kaiicheng/CPR-For-All/CPR for All Final Presentation.pdf

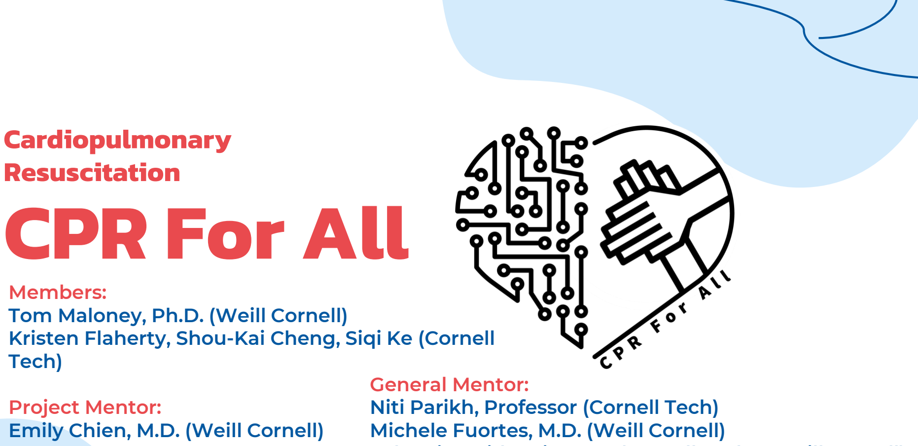
[picture p6: figure]
Cardiopulmonary Resuscitation CPR For All; Members: Tom Maloney, Ph.D. (Weill Cornell); Tech); Project Mentor: Emily Chien, M.D. (Weill Cornell); General Mentor: Niti Parikh, Professor (Cornell Tech) Michele Fuortes, M.D. (Weill Cornell)

Kristen Flaherty, Shou-Kai Cheng, Siqi Ke (Cornell

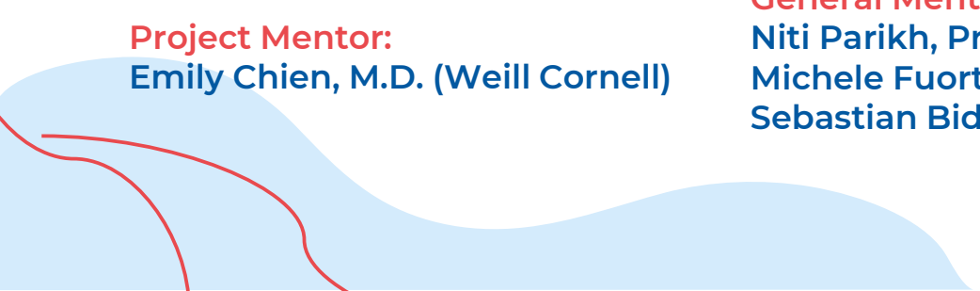
[picture p7: figure]

Sebastian Bidegain, M.D. (Cornell Tech & Weill Cornell)

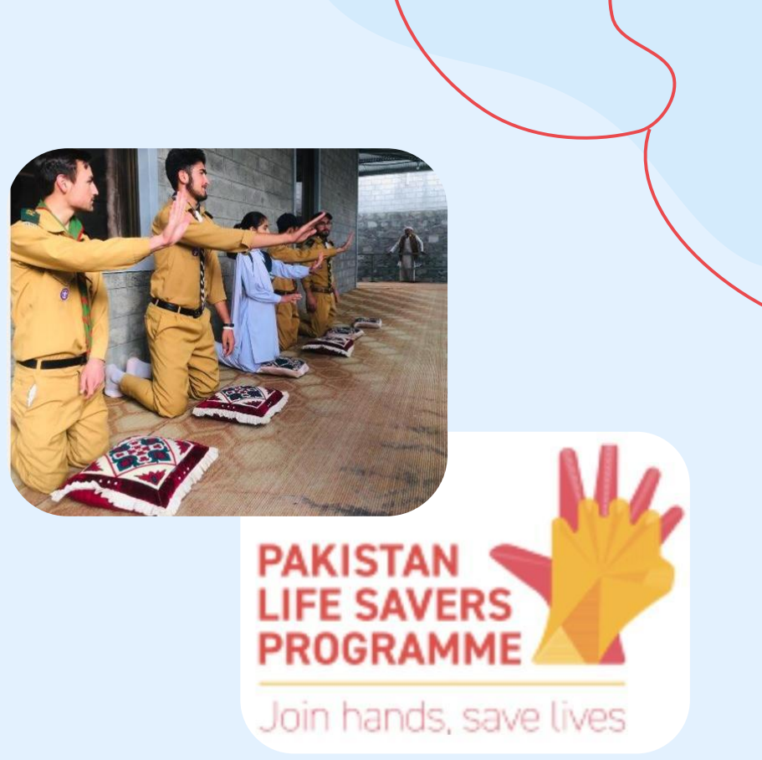
[picture p8: figure]

# The Challenge

### CRP For All

## How Might We create a low-cost version of a CPR model that appropriately simulates the compression force and depth required for high-quality CPR?

# User Groups & Needs

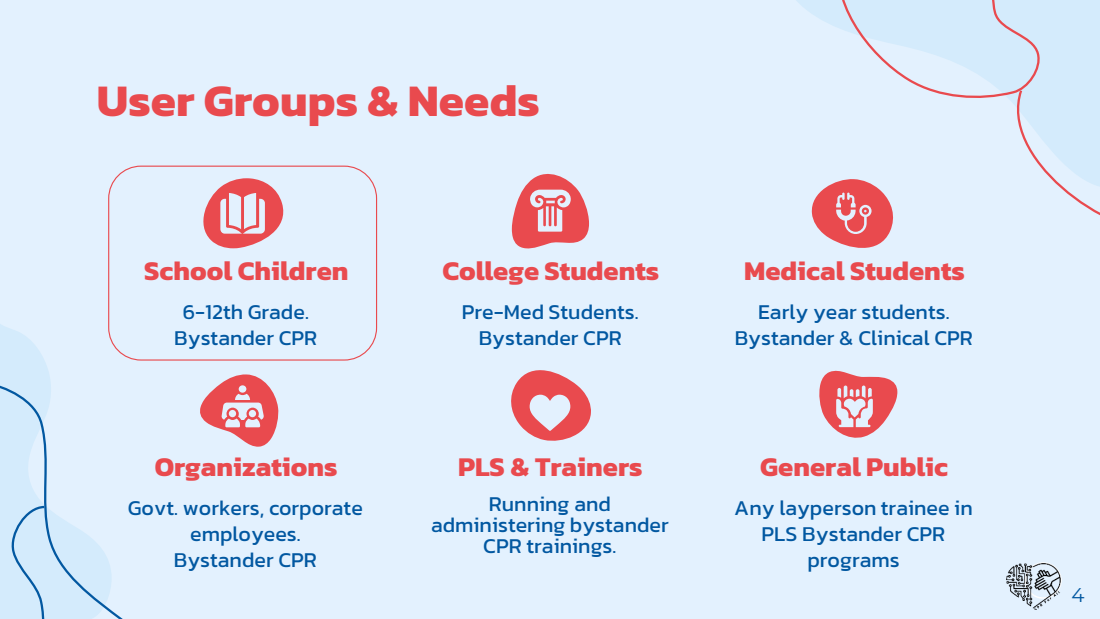
[picture p9: page 3]
PLS & Trainers Running and administering bystander CPR trainings.; School Children 6-12th Grade. Bystander CPR

College Students
Pre-Med Students.
Bystander CPR

Medical Students
Early year students.
Bystander & Clinical CPR

Organizations
Govt. workers, corporate
employees.

General Public
Any layperson trainee in
PLS Bystander CPR
programs

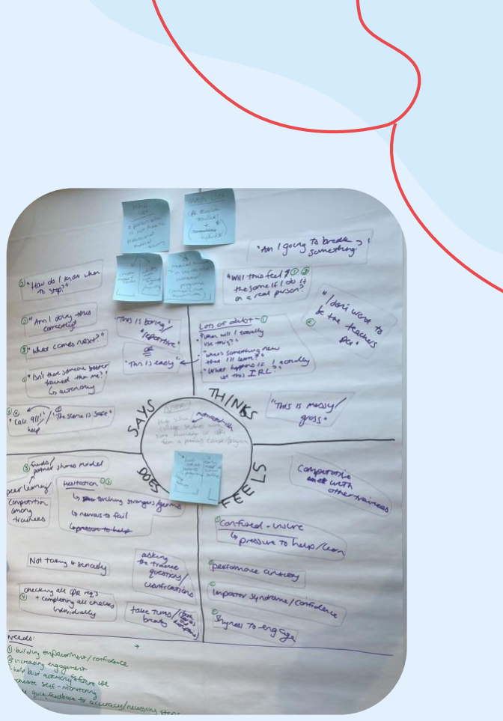
[picture p10: figure]

# Design Challenge Framework

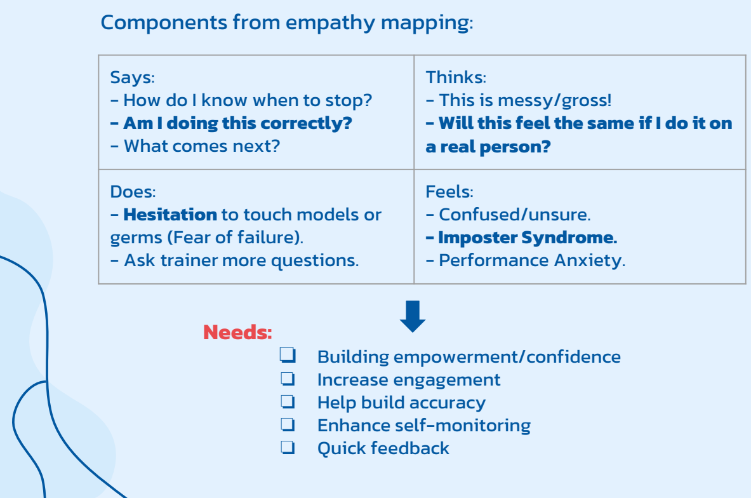
[picture p11: figure]
Needs:; ❏ Building empowerment/confidence ❏ Increase engagement ❏ Help build accuracy ❏ Enhance self-monitoring ❏ Quick feedback; Components from empathy mapping:

Says: - How do I know when to stop? - Am I doing this correctly? - What comes next? | Thinks: - This is messy/gross! - Will this feel the same if I do it on a real person?
Does: - Hesitation to touch models or germs (Fear of failure). - Ask trainer more questions. | Feels: - Confused/unsure. - Imposter Syndrome. - Performance Anxiety.

# Interview Takeaways

Pakistan Life Savers Program

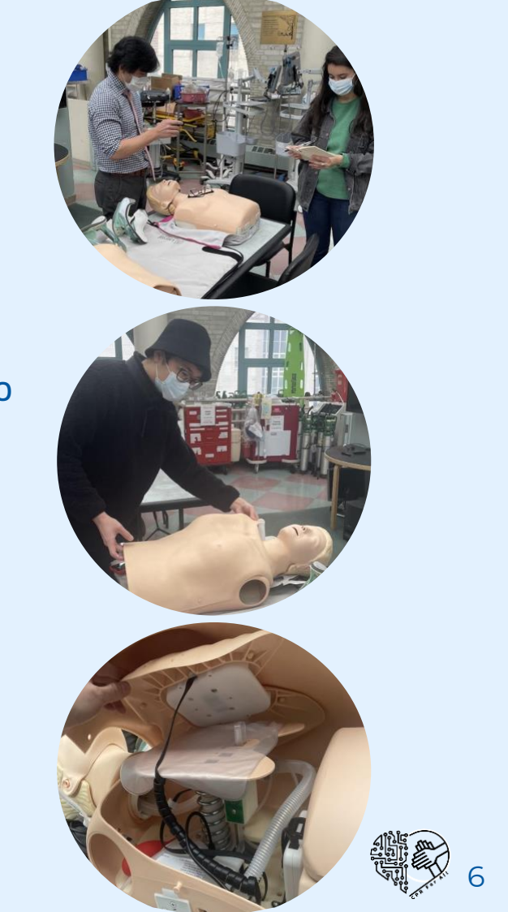
[picture p12: figure]

- Recent implementation of CPR into national education curriculum, ~10 million students 6th-12th grade
- Every trainee has one pillow and shares an expensive training mannequin
- Low resourced, high work output
- Need an affordable, portable, scalable, reproducible CPR model to deploy in their programs
CPR Training
- Compressions (depth, rate, hand placement, length) is necessary to teach in bystander CPR over ventilation
- 2-2.5 inches deep at 100-120 cpm for 2 minutes
- Deliver high quality, intuitive feedback without increasing cost

### 4 Emergency Medicine Physicians @ Weill Cornell

# Project Goals & Constraints

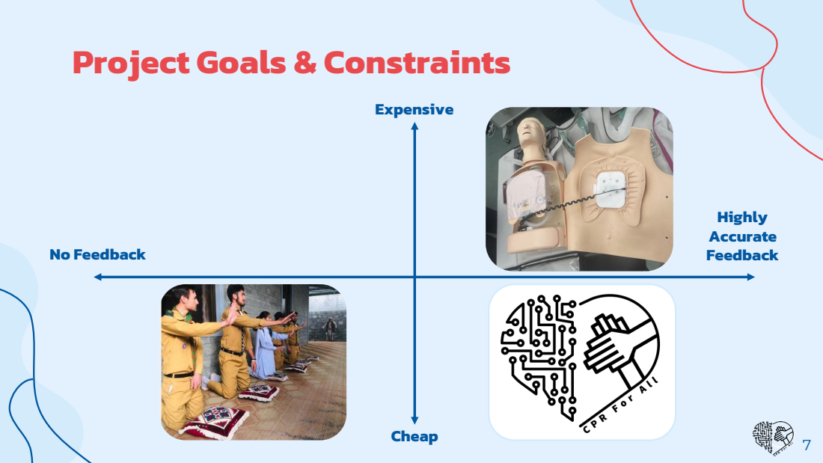
[picture p13: page 6]
Expensive; Cheap; No Feedback; Highly Accurate Feedback

# Project Goals & Constraints

## Goals ❏ Compression only ❏ Accurate depth and rate feedback ❏ Scalable and portable for schools

## Constraints

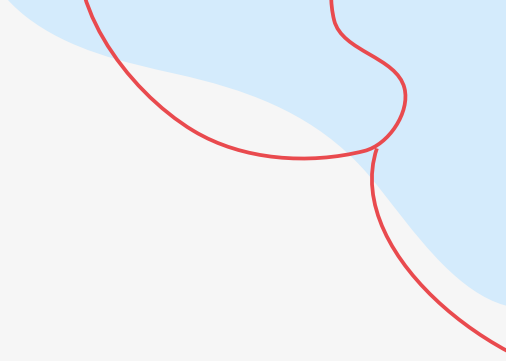
[picture p14: figure]

## ❏ Low cost, affordable objects ❏ Reproducible ❏ Easy to assemble ❏ Repairable

# Prototype

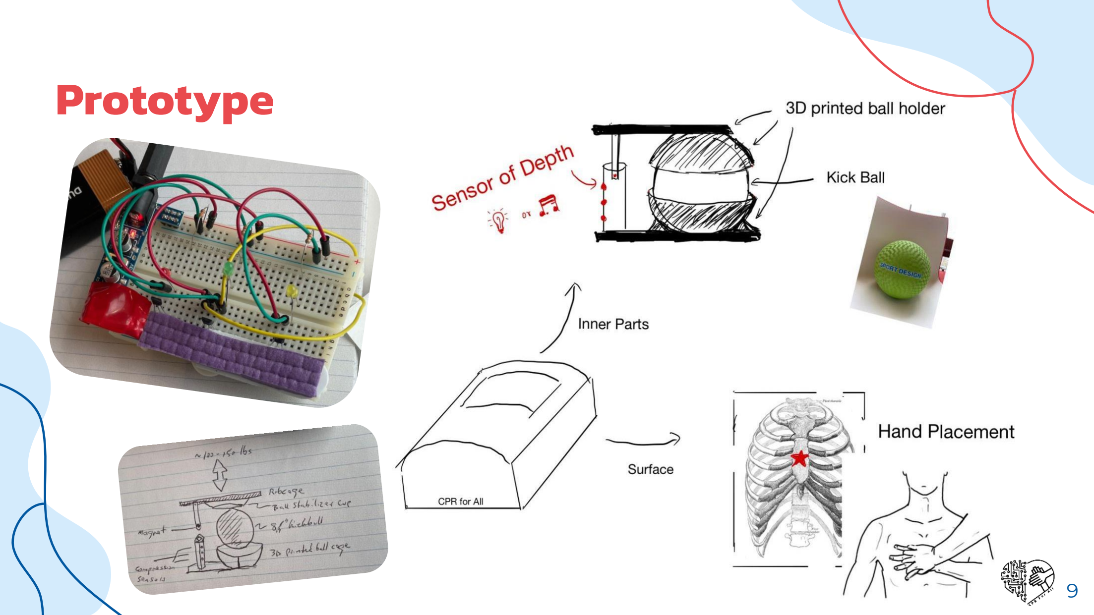
[picture p15: page 8]

# Final CPR Compression Trainer

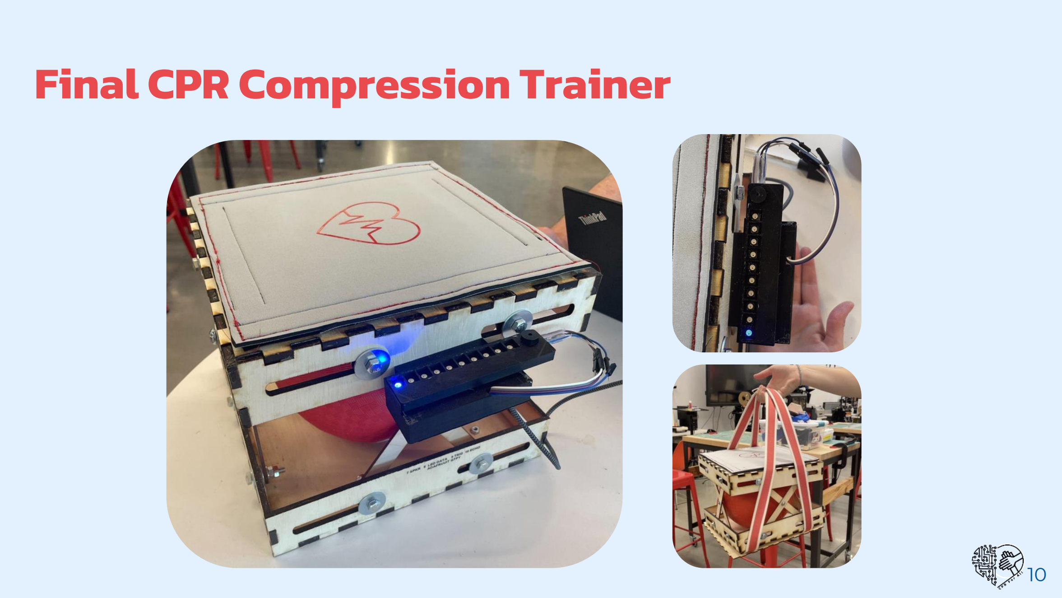
[picture p16: page 9]
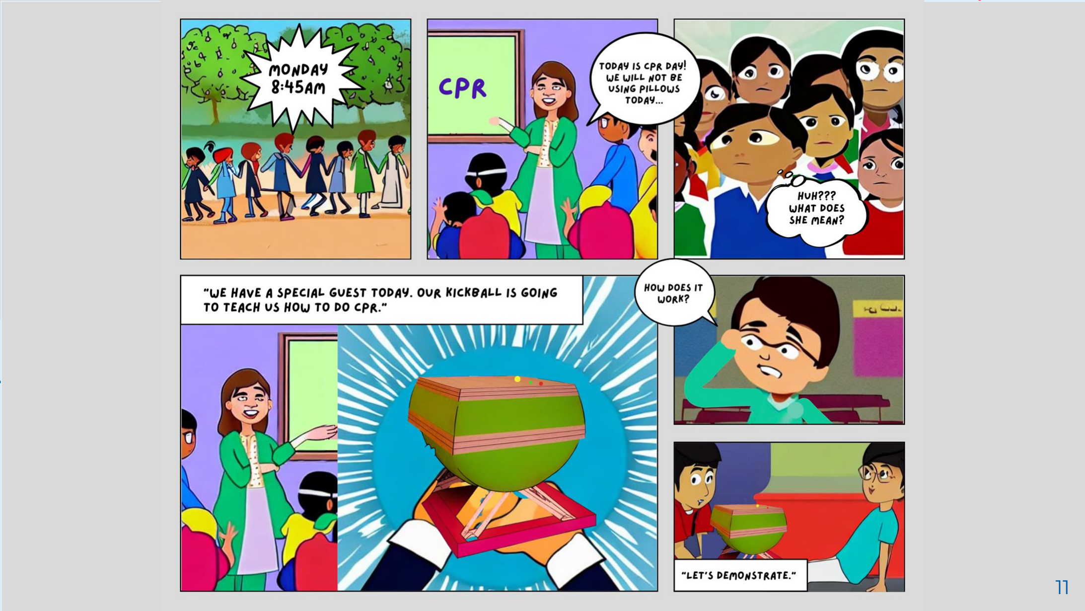
[picture p17: page 10]
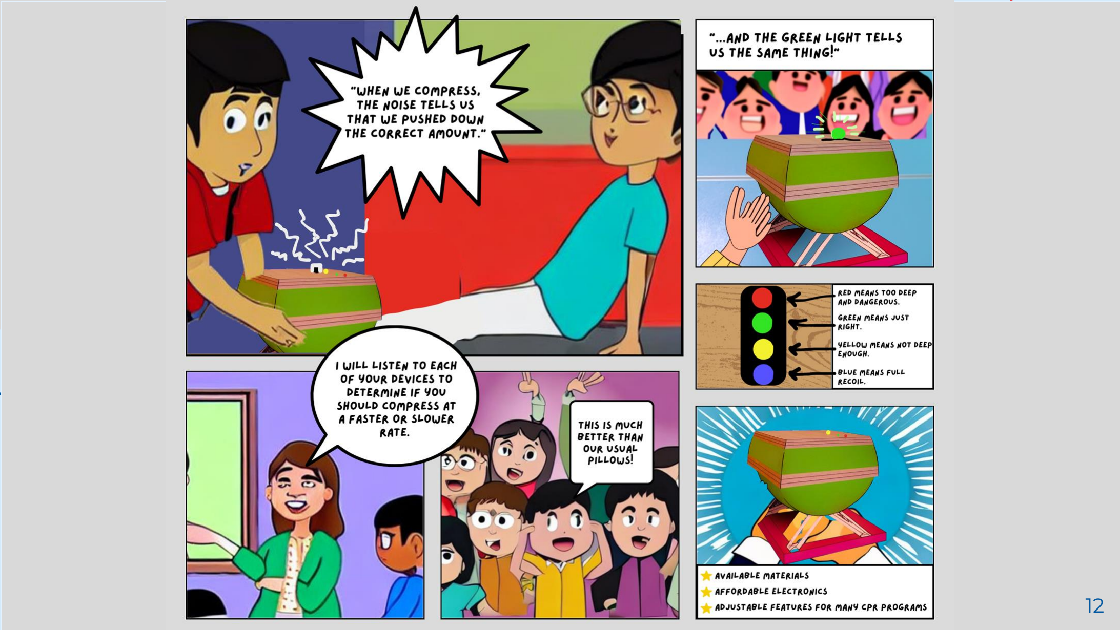
[picture p18: page 11]

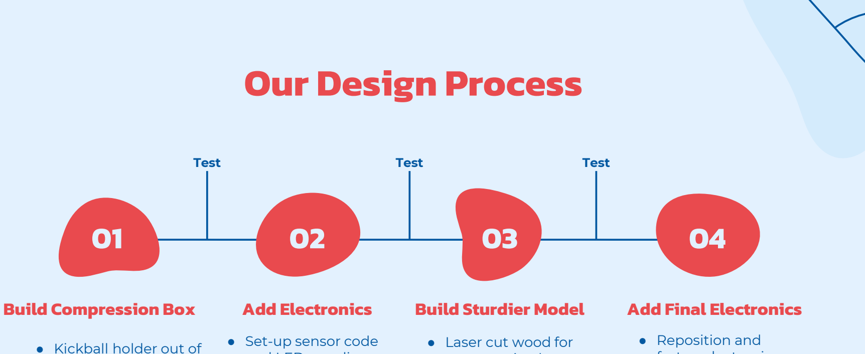
[picture p19: figure]
Our Design Process; Build Compression Box; Add Electronics; Build Sturdier Model; Add Final Electronics; ● Set-up sensor code; ● Laser cut wood for; ● Reposition and; Test

- Kickball holder out of
cardboard

and LED + audio
feedback on
compression depth

compression box
- 3D-printed pieces
to hold electronics

fasten electronics
and all parts

# Cardboard Model

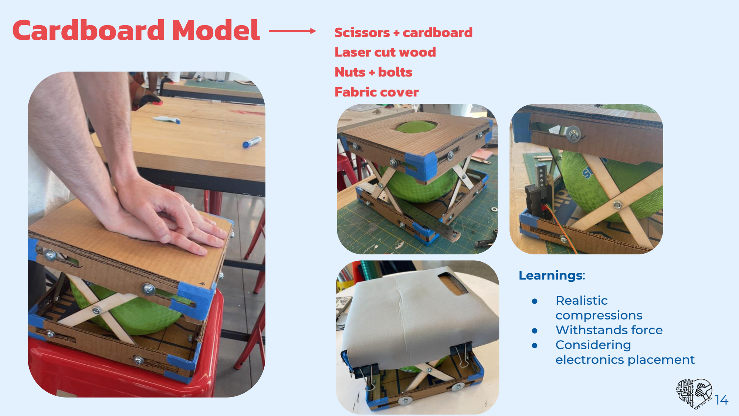
[picture p20: page 13]

Learnings:
- Realistic
compressions
- Withstands force
- Considering
electronics placement

Scissors + cardboard
Laser cut wood
Nuts + bolts
Fabric cover

# Cardboard Model + Electronics

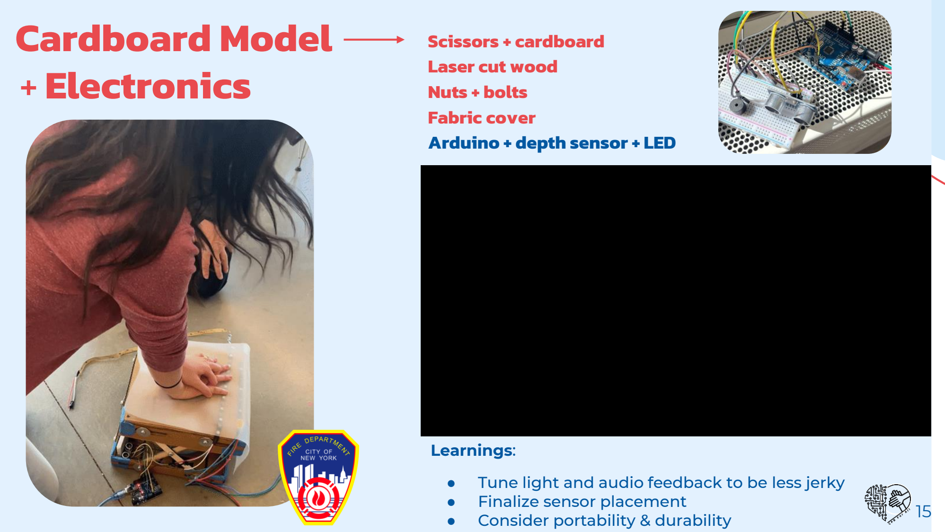
[picture p21: page 14]

Learnings:
- Tune light and audio feedback to be less jerky
- Finalize sensor placement
- Consider portability & durability

Scissors + cardboard
Laser cut wood
Nuts + bolts
Fabric cover
Arduino + depth sensor + LED

# Final CPR Model

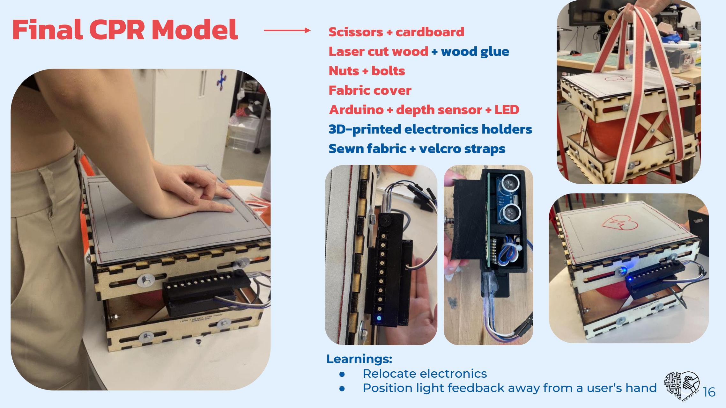
[picture p22: page 15]

Learnings:
- Relocate electronics
- Position light feedback away from a user’s hand

Scissors + cardboard
Laser cut wood + wood glue Nuts + bolts
Fabric cover
Arduino + depth sensor + LED 3D-printed electronics holders Sewn fabric + velcro straps

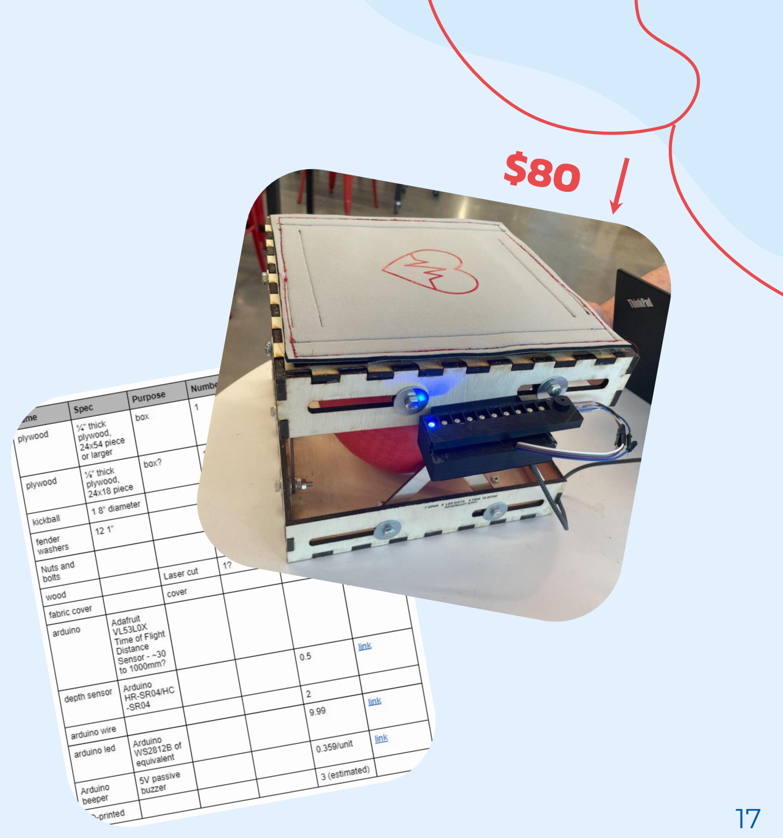
[picture p23: figure]

# User Manual and Costs

- User manual (link (https://docs.google.com/document/d/1pwOQY6LLWeu2-WrqhiwFXcap4NURnqS5RL8z-PJ1cMg/edit)

)
- | Supplies ○ | DIY instructions ○ Building process ○ | Arduino code ○ | Laser cut wood file ○ | Estimated costs (below $80)
- Keep improving our model for ○ | May 19: Spring 2023 Open
| Studio
- July 17: International
| Symposium on Academic Makerspaces 2023

# Thanks!

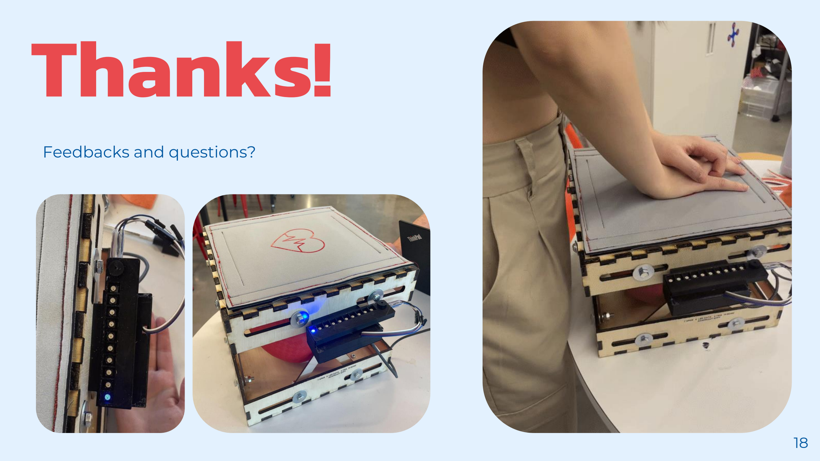
[picture p24: page 17]

CREDITS: This presentation template was created by Slidesgo, (http://bit.ly/2Tynxth) including icons by Flaticon, (http://bit.ly/2TyoMsr) and infographics & images by Freepik (http://bit.ly/2TtBDfr)

Feedbacks and questions?
