kaiicheng/CPR-For-All/CPR for All Mid-Checkpoint Presentation.pdf

## Cardiopulmonary Resuscitation

# CPR For All

Tom Maloney (Weill Cornell)

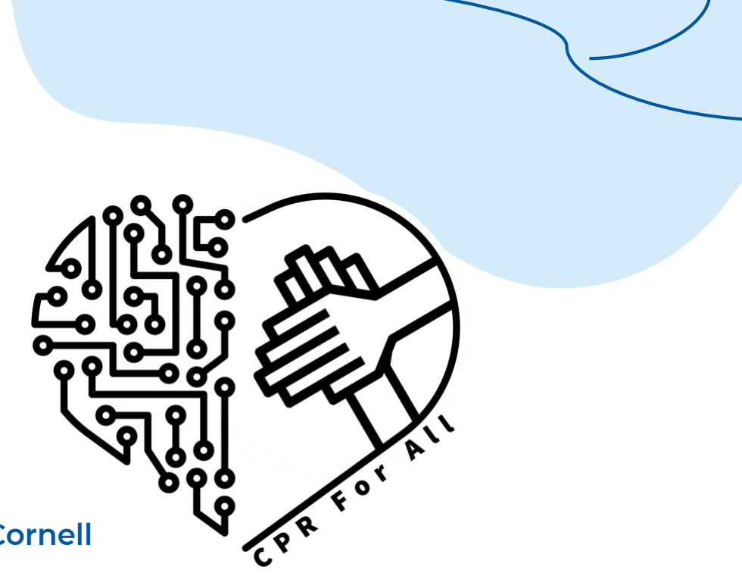
[picture p29: figure]

Kristen Flaherty, Shou-Kai Cheng, Siqi Ke (Cornell

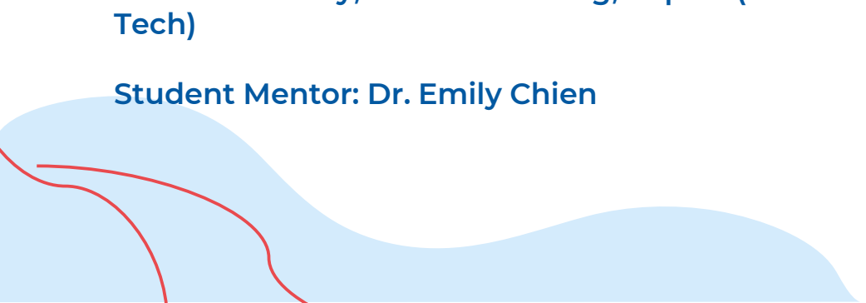
[picture p30: figure]
Tech); Student Mentor: Dr. Emily Chien

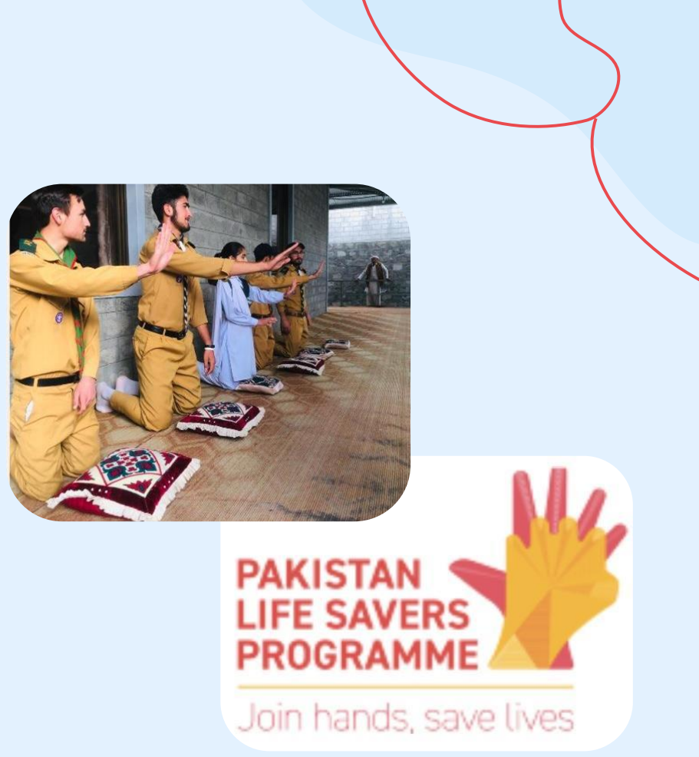
[picture p31: figure]

# The Challenge

### CRP For All

## How Might We create a low-cost version of a CPR model that

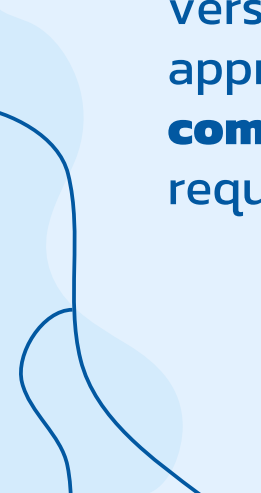
[picture p32: figure]

## appropriately simulates the compression force and depth required for high-quality CPR?

# User Groups & Needs

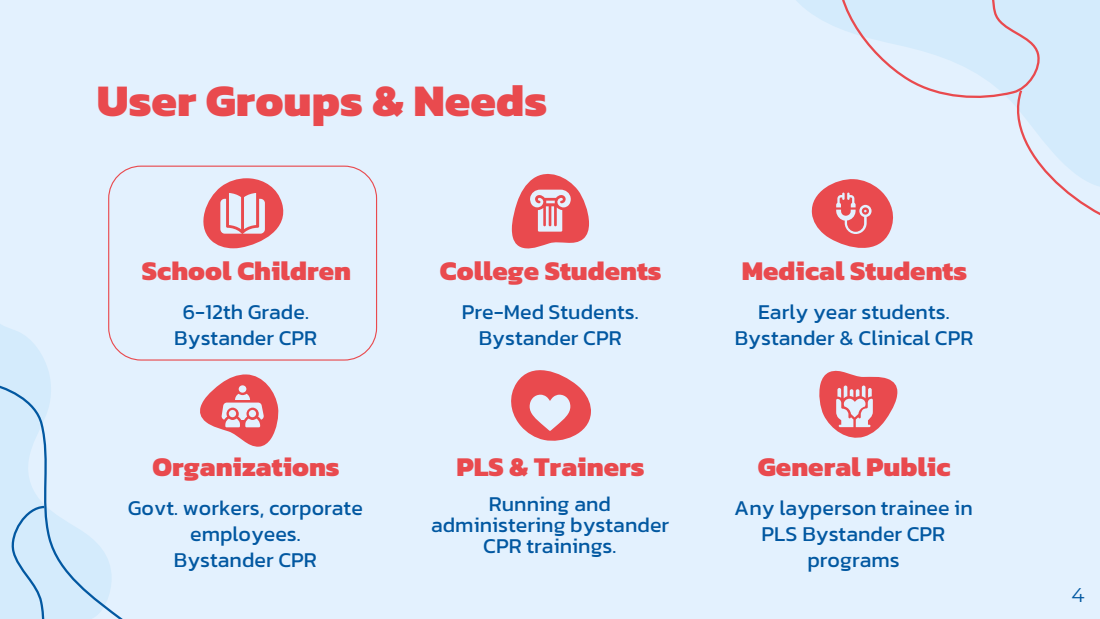
[picture p33: page 3]
PLS & Trainers Running and administering bystander CPR trainings.; School Children 6-12th Grade. Bystander CPR

College Students
Pre-Med Students.
Bystander CPR

Medical Students
Early year students.
Bystander & Clinical CPR

Organizations
Govt. workers, corporate
employees.

General Public
Any layperson trainee in
PLS Bystander CPR
programs

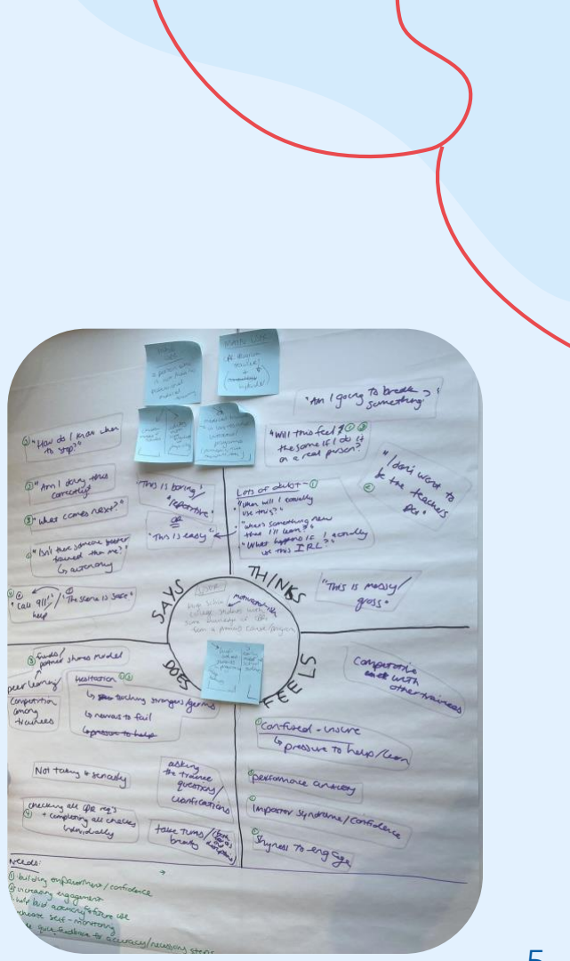
[picture p34: figure]

# Design Challenge Framework

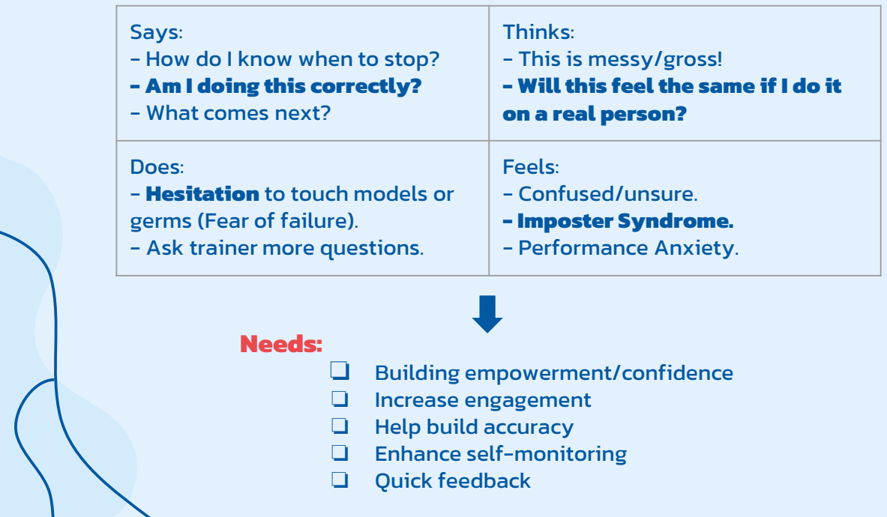
[picture p35: figure]
Needs:; ❏ Building empowerment/confidence ❏ Increase engagement ❏ Help build accuracy ❏ Enhance self-monitoring ❏ Quick feedback

Says: - How do I know when to stop? - Am I doing this correctly? - What comes next? | Thinks: - This is messy/gross! - Will this feel the same if I do it on a real person?
Does: - Hesitation to touch models or germs (Fear of failure). - Ask trainer more questions. | Feels: - Confused/unsure. - Imposter Syndrome. - Performance Anxiety.

Components from empathy mapping:

# Interview Takeaways

Pakistan Life Savers Program

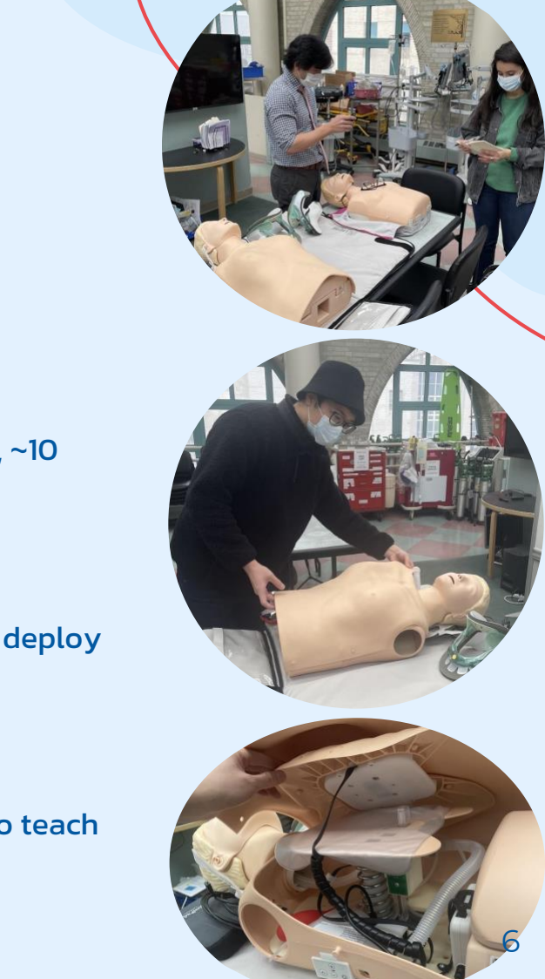
[picture p36: figure]

- Recent implementation of CPR into national education curriculum, ~10

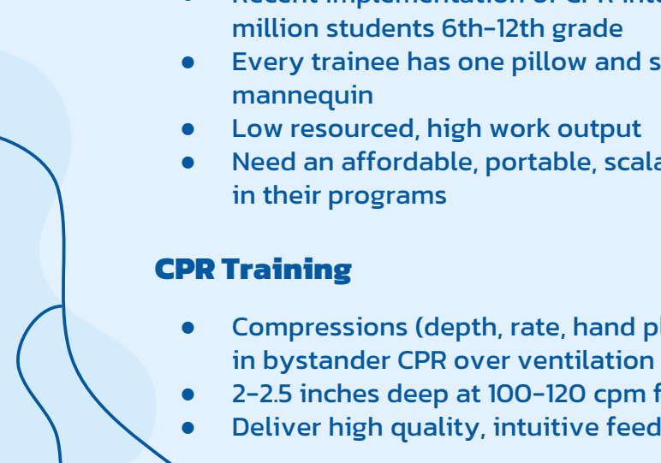
[picture p37: figure]
million students 6th-12th grade; mannequin ● Low resourced, high work output; in their programs CPR Training; in bystander CPR over ventilation

- Every trainee has one pillow and shares an expensive training
- Need an affordable, portable, scalable, reproducible CPR model to deploy
- Compressions (depth, rate, hand placement, length) is necessary to teach
- 2-2.5 inches deep at 100-120 cpm for 2 minutes
- Deliver high quality, intuitive feedback without increasing cost

### 4 Emergency Medicine Physicians @ Weill Cornell

# Project Goals & Constraints

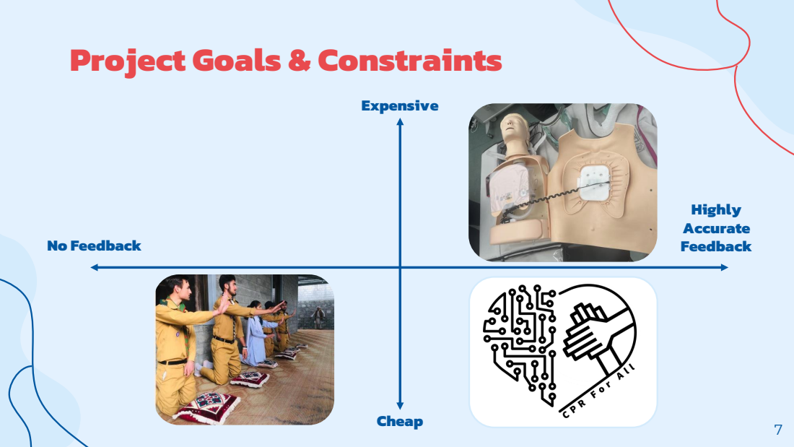
[picture p38: page 6]
Expensive; Cheap; No Feedback; Highly Accurate Feedback

# Project Goals & Constraints

## Goals ❏ Compression only ❏ Accurate depth and rate feedback ❏ Scalable and portable for schools

## Constraints

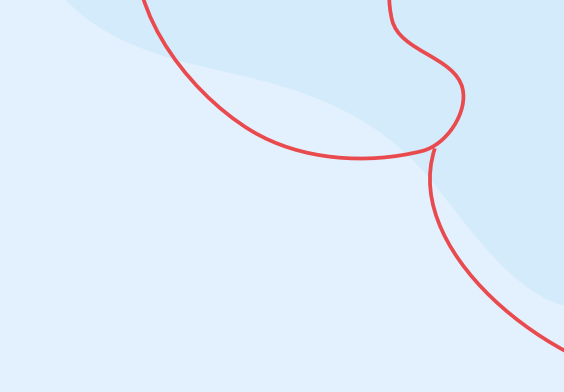
[picture p39: figure]

## ❏ Low cost, affordable objects ❏ Reproducible ❏ Easy to assemble ❏ Repairable

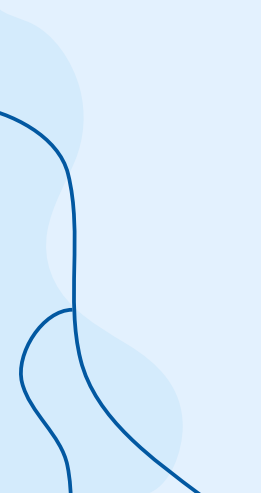
[picture p40: figure]

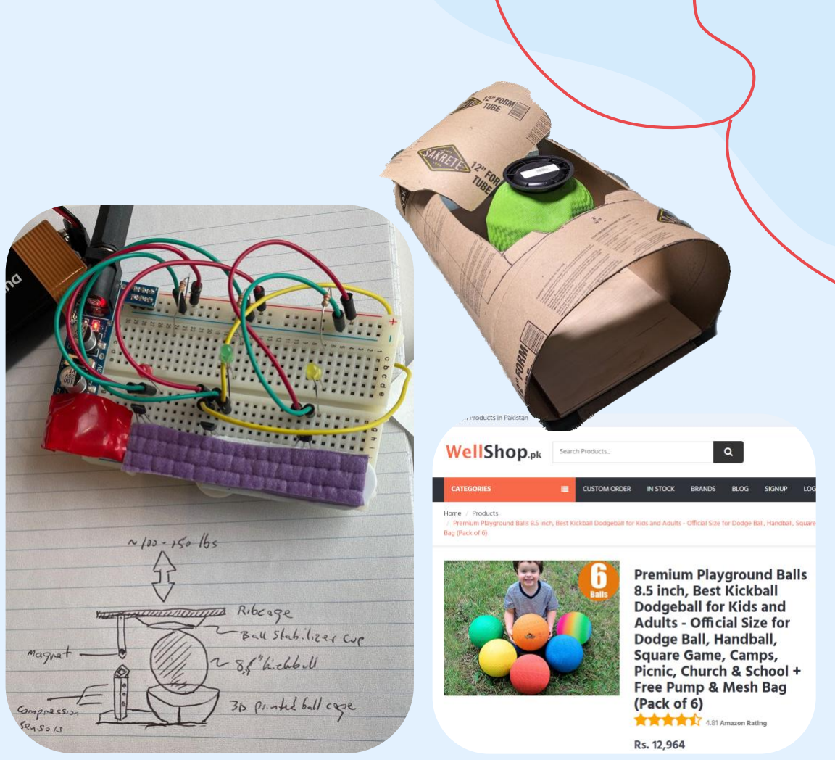
[picture p41: figure]

Proof of Concept ❏ Compression training device ❏ Using a kickball to simulate

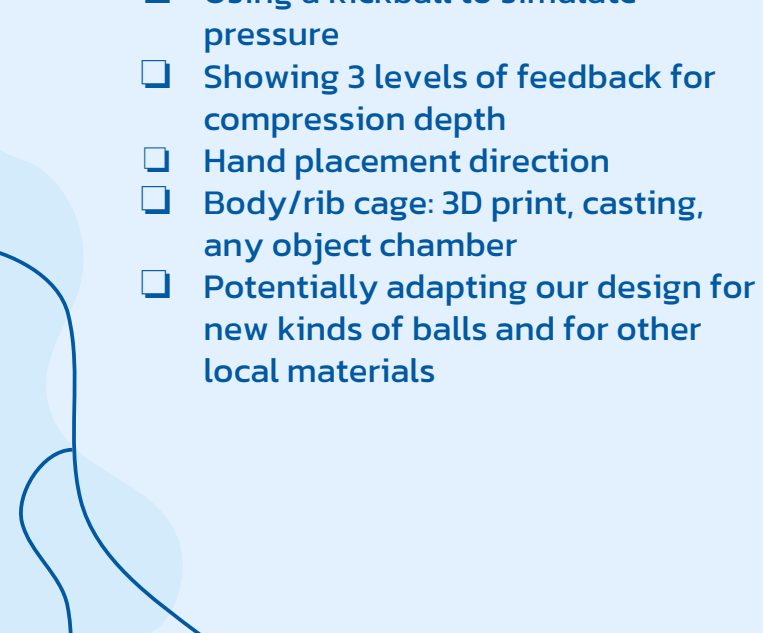
[picture p42: figure]
pressure ❏ Showing 3 levels of feedback for compression depth; any object chamber ❏ Potentially adapting our design for new kinds of balls and for other local materials

❏ Hand placement direction ❏ Body/rib cage: 3D print, casting,

# Prototype

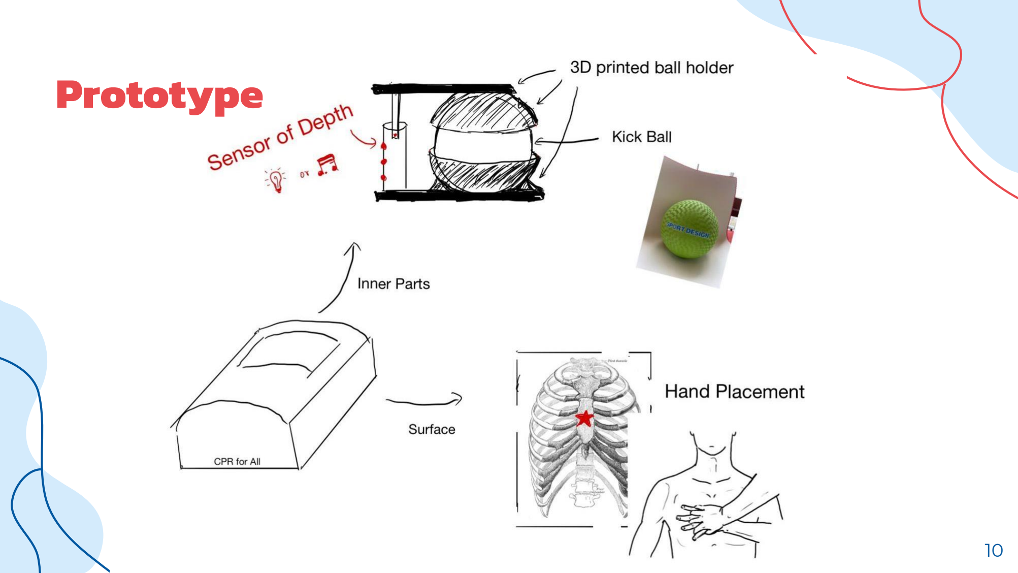
[picture p43: page 9]

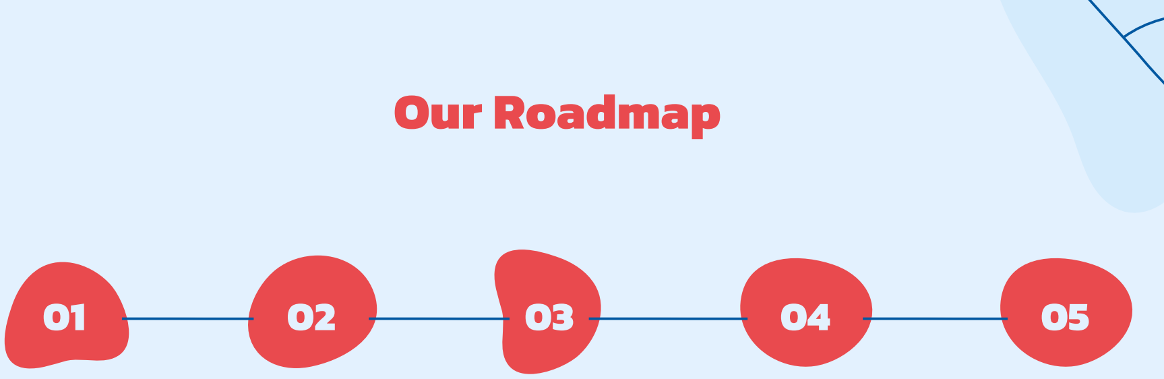
[picture p44: figure]
Our Roadmap

Simulate Chest
Compressions
- Kickball + feedback 3D
printed holder
- Feedback electronics +
rod/piston cylinder

Tune System
Accuracy

Add Hand
Placement

Build Chest Cage

Assess & Tune
Usability
- Test and finalize
feedback sensor
placement and
response to correct
compression depth
- Design and build the
chamber for our
system to hold
kickball, stand and
feedback electronics
- Design the top of
the chamber to
instruct correct
hand placement
- Test with users and
identify design
components to
improve

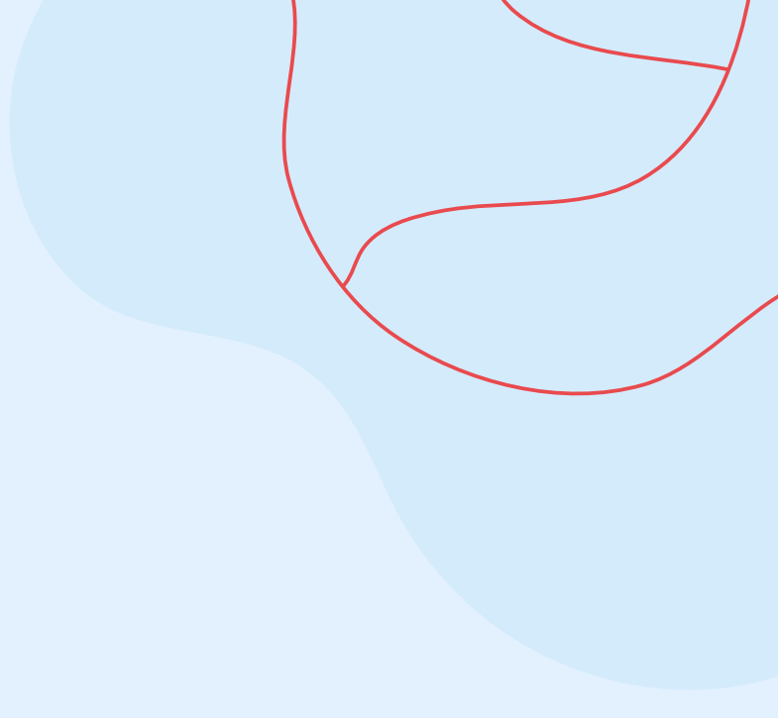
[picture p45: figure]

CREDITS: This presentation template was created by Slidesgo, (http://bit.ly/2Tynxth) including icons by Flaticon, (http://bit.ly/2TyoMsr) and infographics & images by Freepik (http://bit.ly/2TtBDfr)

# Thanks!

Does anyone have any questions?
