kaiicheng/CPR-For-All/images/Arduino 1.png

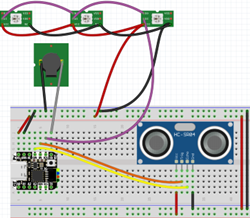
images/Arduino 1.png
