kaiicheng/CPR-For-All/images/CPR Model 1.gif

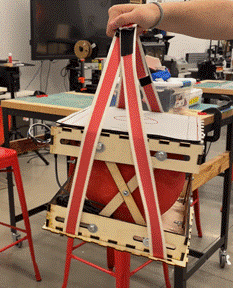
images/CPR Model 1.gif
