kaiicheng/CPR-For-All/images/CPR Model 2.jpg

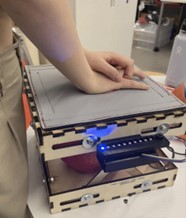
images/CPR Model 2.jpg
