kaiicheng/CPR-For-All/images/CPR Model 3.gif

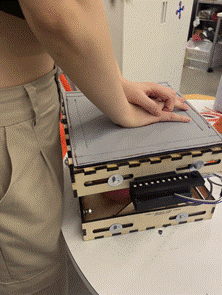
images/CPR Model 3.gif
