kaiicheng/CPR-For-All/images/CPR Model 4.jpg

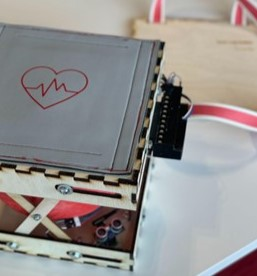
images/CPR Model 4.jpg
