kaiicheng/CPR-For-All/images/CPR Model 5.jpg

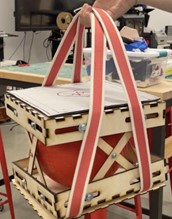
images/CPR Model 5.jpg
