kaiicheng/CPR-For-All/(commit log)

2024-02-06 upload Arduino photo 1
2024-02-06 update Arduino photo 1
